miki-fp/Budget_Joycons/3D Models/b3f-1020.stp

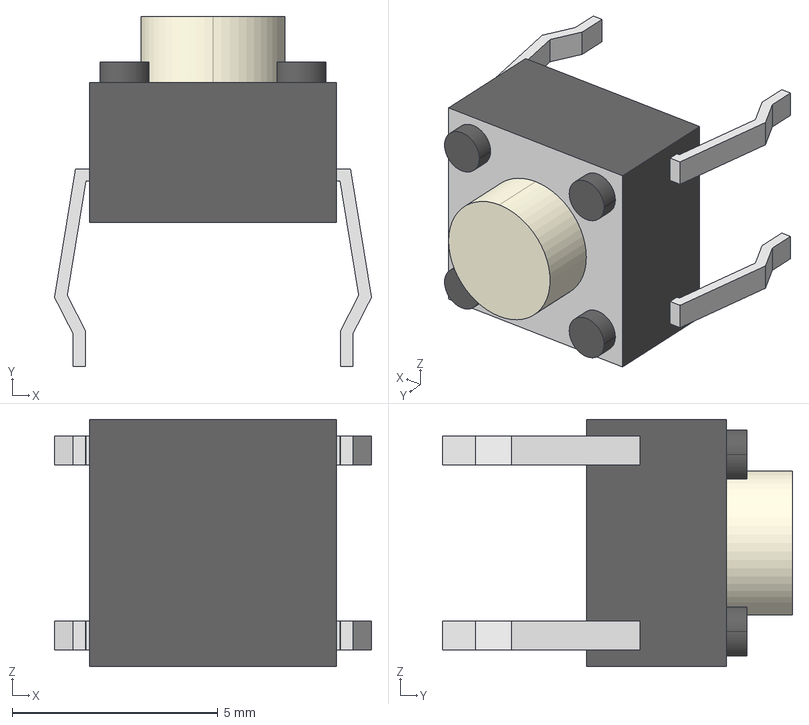
[picture p1: CAD file, 2026-07-12]
3D Models/b3f-1020.stp
7.70 x 8.50 x 6.00 mm
