miki-fp/Budget_Joycons/3D Models/S2B-PH-K-S.STEP

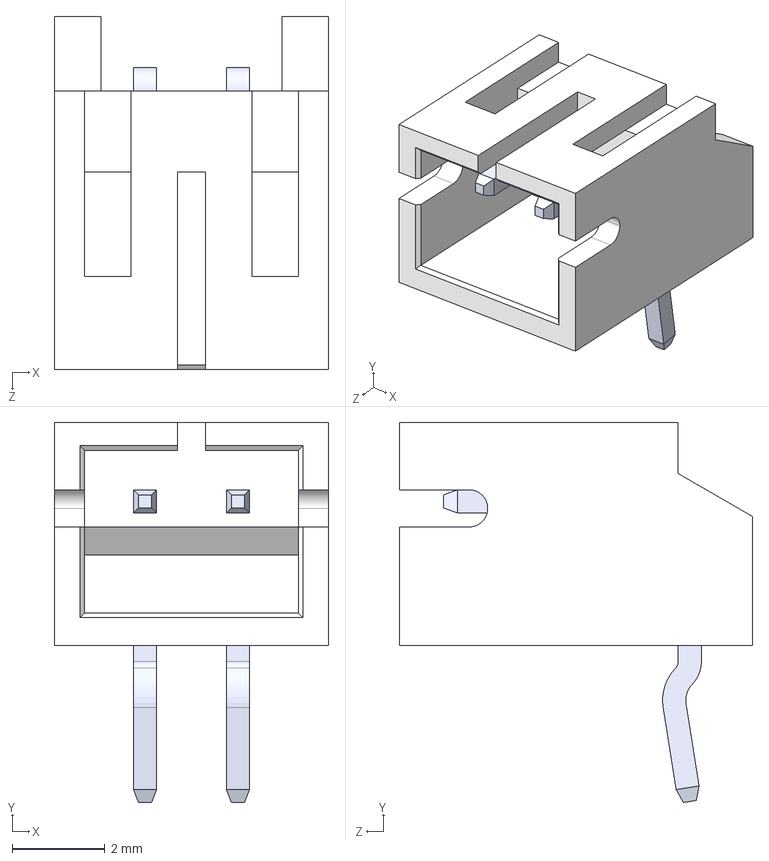
[picture p2: CAD file, 2026-07-12]
3D Models/S2B-PH-K-S.STEP
5.90 x 8.18 x 7.60 mm
