miki-fp/Budget_Joycons/3D Models/UJ20-C-H-G-SMT-2A-P16-TR.step

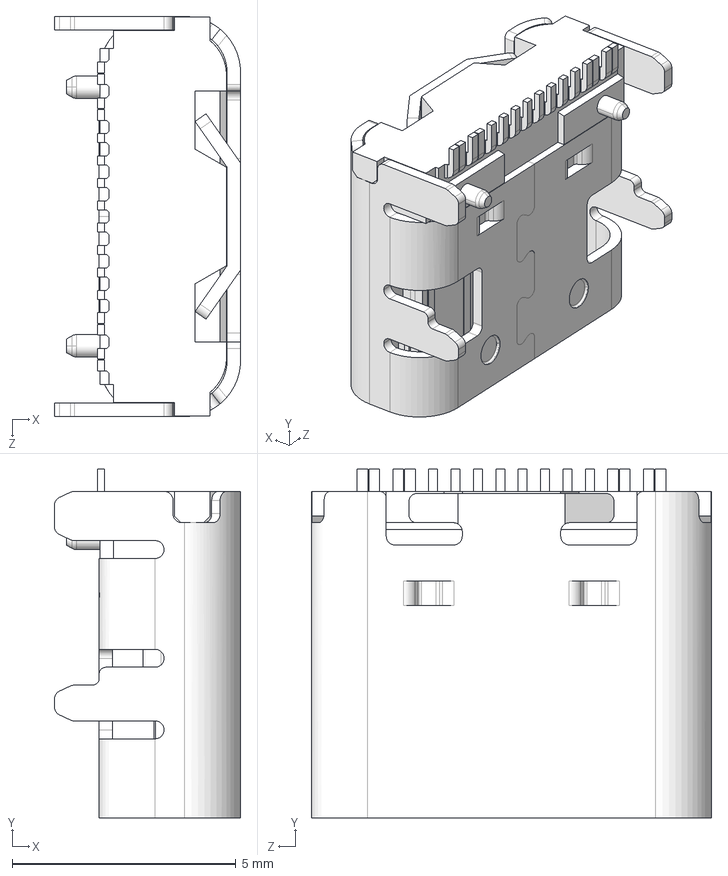
[picture p3: CAD file, 2026-07-12]
3D Models/UJ20-C-H-G-SMT-2A-P16-TR.step
4.16 x 7.80 x 8.94 mm
