miki-fp/Budget_Joycons/3D Models/SKSCLB.STEP

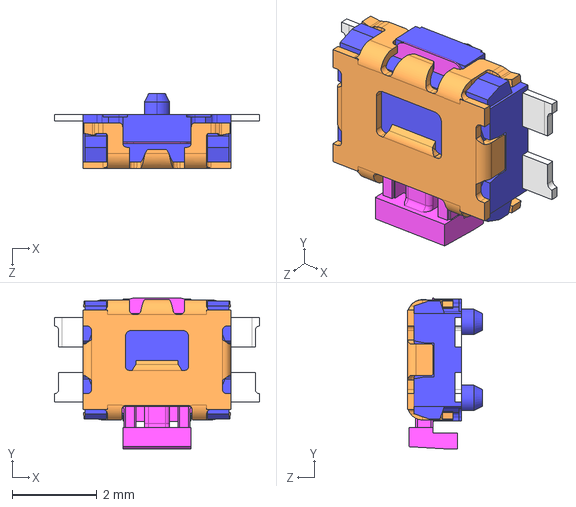
[picture p4: CAD file, 2026-07-12]
3D Models/SKSCLB.STEP
4.85 x 3.57 x 1.77 mm
