miki-fp/Budget_Joycons/3D Models/LQFP48_1_STM.step

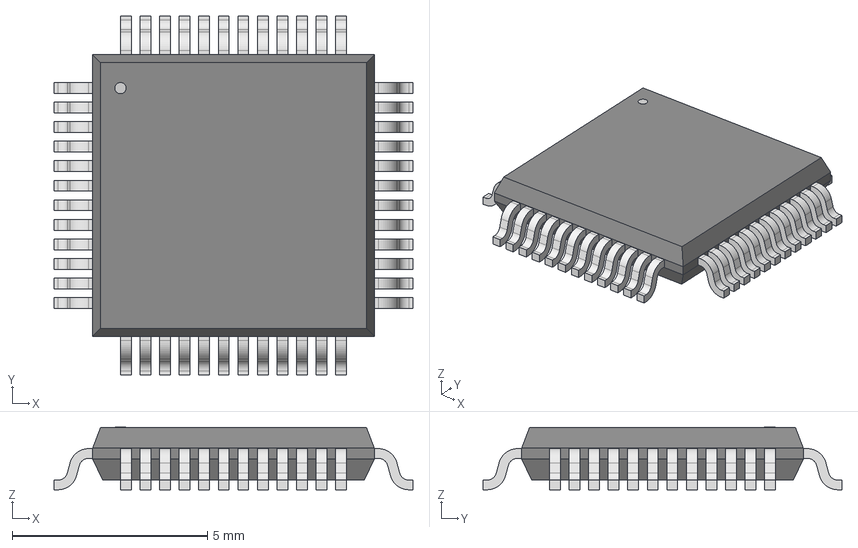
[picture p5: CAD file, 2026-07-12]
3D Models/LQFP48_1_STM.step
9.19 x 9.19 x 1.60 mm
