miki-fp/Budget_Joycons/3D Models/TL3315NF100Q.step

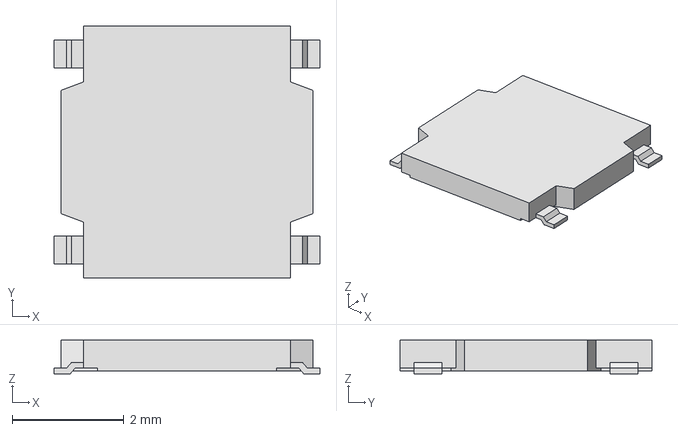
[picture p6: CAD file, 2026-07-12]
3D Models/TL3315NF100Q.step
4.75 x 4.50 x 0.6 mm
