miki-fp/Budget_Joycons/3D Models/SM02B-SRSS-TB_LF__SN_.stp

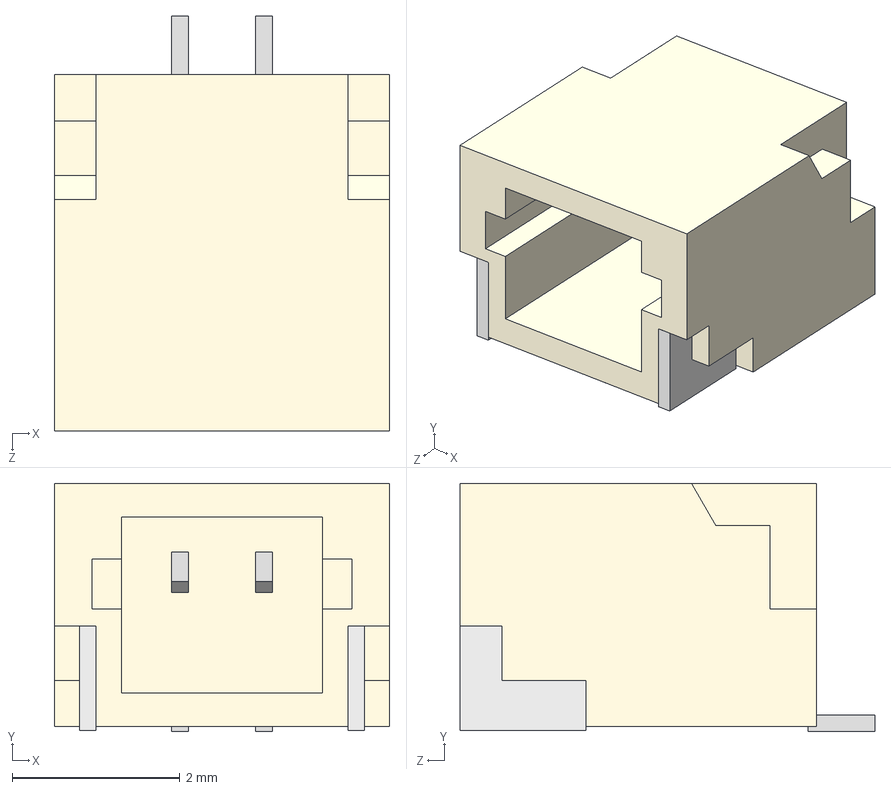
[picture p7: CAD file, 2026-07-12]
3D Models/SM02B-SRSS-TB_LF__SN_.stp
4.00 x 2.96 x 4.95 mm
