miki-fp/Budget_Joycons/3D Models/530480210.stp

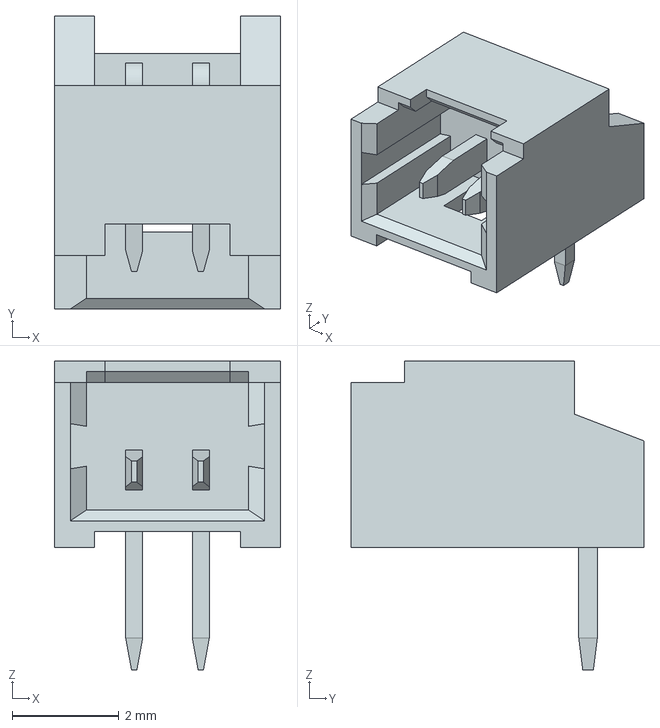
[picture p8: CAD file, 2026-07-12]
3D Models/530480210.stp
4.25 x 5.50 x 5.80 mm
