miki-fp/Budget_Joycons/Right Controller/Budget Joycons (Right).kicad_pcb

## KiCad design Right Controller/Budget Joycons (Right).kicad_pcb (2026-07-15)

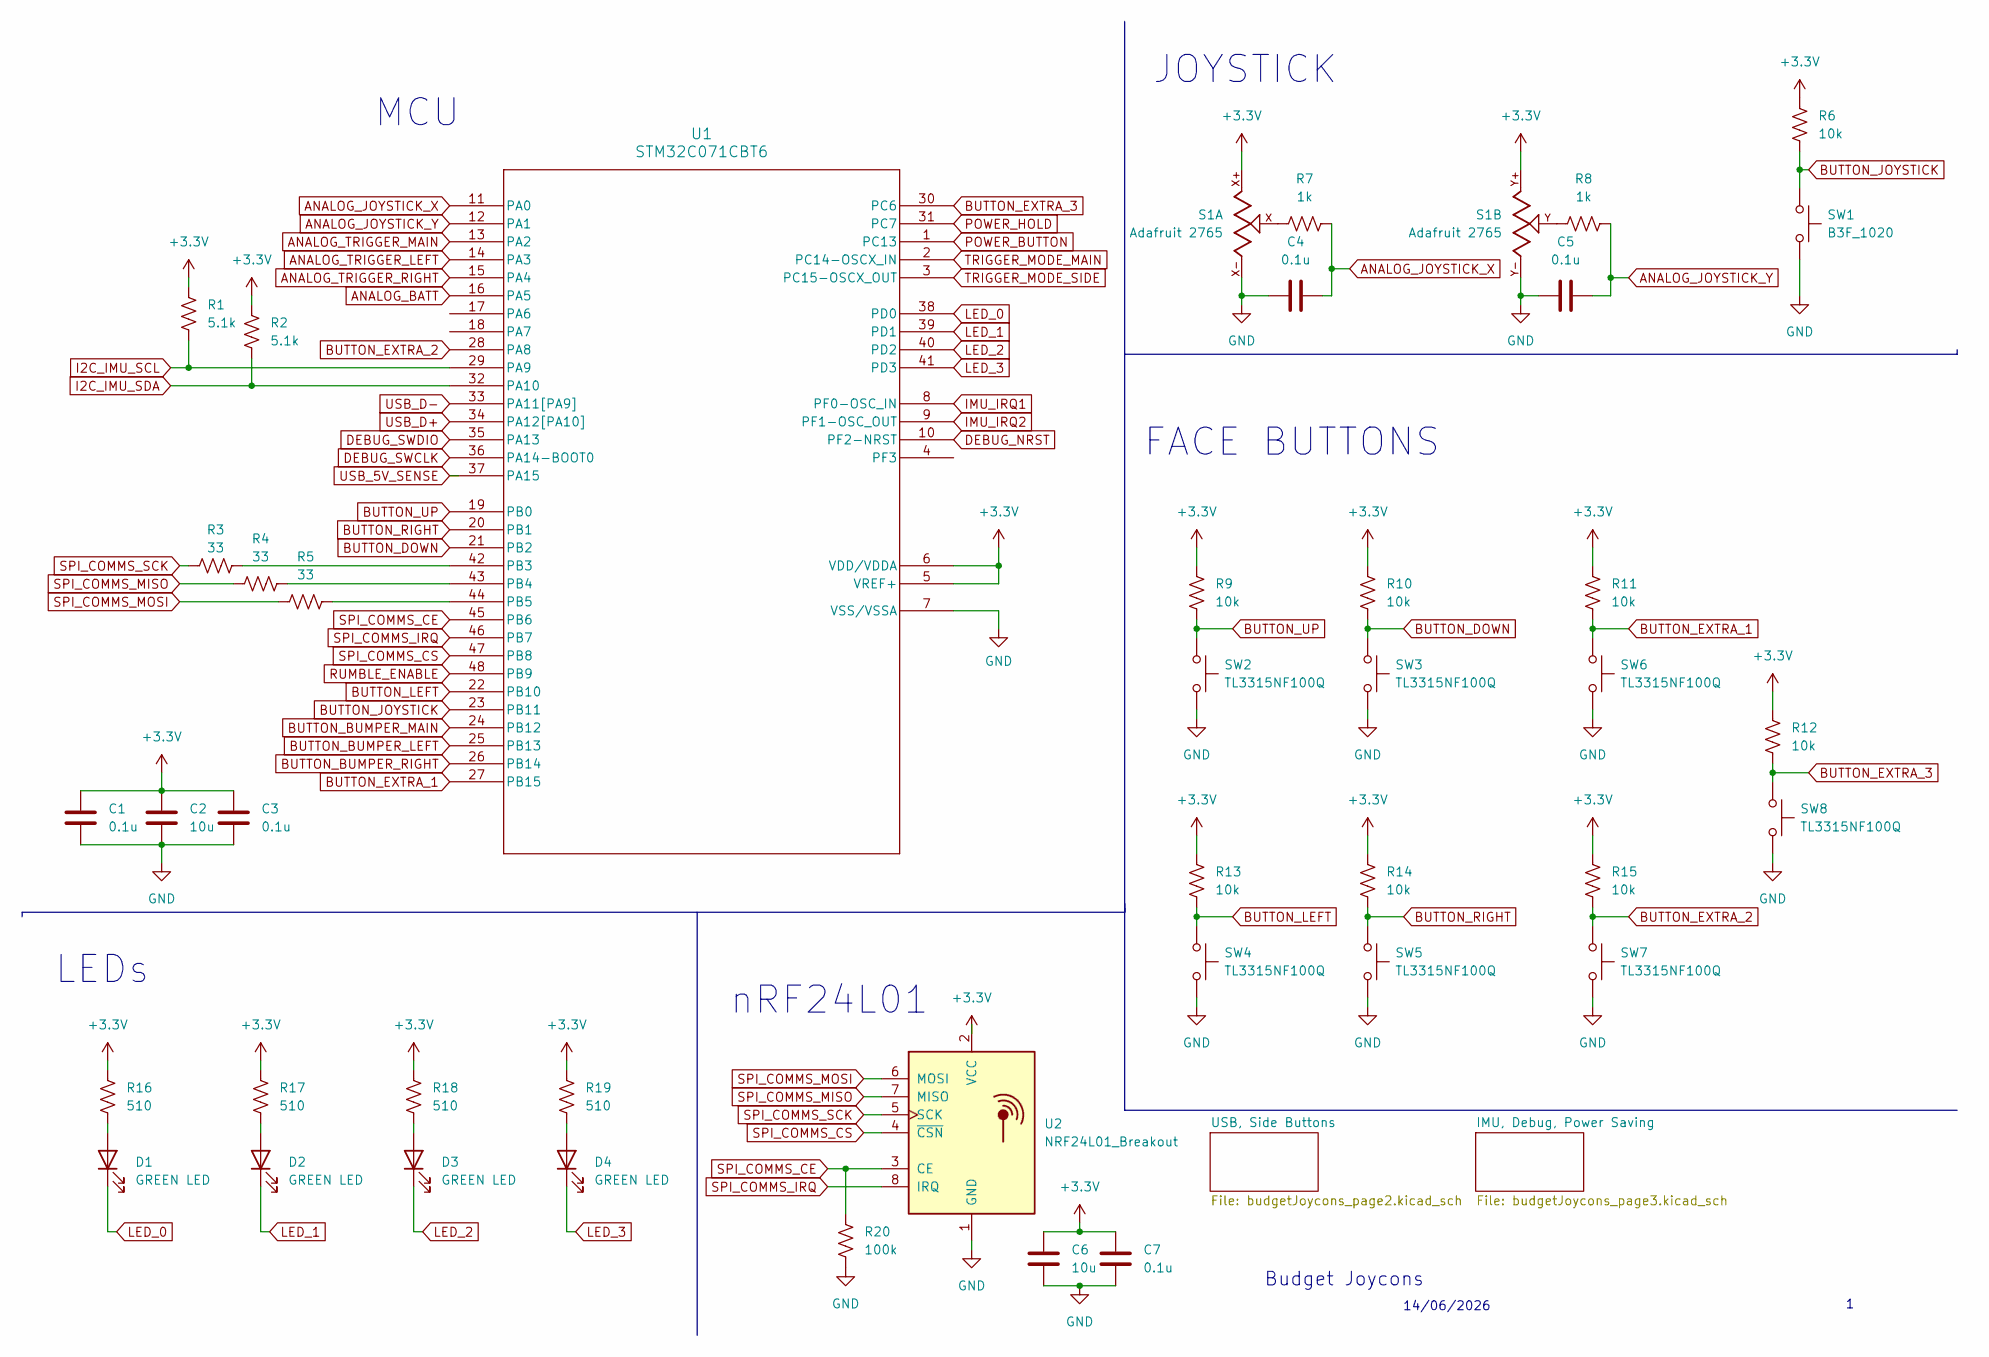
[picture p9: schematic BudgetJoycons_pcb.kicad_sch]

Parts:
C1, C3, C4, C5, C7: 0.1u; C_0603_1608Metric_Pad1.08x0.95mm_HandSolder
C2, C6: 10u; C_0805_2012Metric_Pad1.18x1.45mm_HandSolder
D1, D2, D3, D4: GREEN LED; LED_0805_2012Metric_Pad1.15x1.40mm_HandSolder
R1, R2: 5.1k; R_0603_1608Metric_Pad0.98x0.95mm_HandSolder
R3, R4, R5: 33; R_0603_1608Metric_Pad0.98x0.95mm_HandSolder
R6, R9, R10, R11, R12, R13, R14, R15: 10k; R_0603_1608Metric_Pad0.98x0.95mm_HandSolder
R7, R8: 1k; R_0603_1608Metric_Pad0.98x0.95mm_HandSolder
R16, R17, R18, R19: 510; R_0805_2012Metric_Pad1.20x1.40mm_HandSolder
R20: 100k; R_0603_1608Metric_Pad0.98x0.95mm_HandSolder
S1: Adafruit 2765; Adafruit_Joystick_2765
SW1: B3F_1020; B3F-1020
SW2, SW3, SW4, SW5, SW6, SW7, SW8: TL3315NF100Q; SW_TL3315NF100Q
U1: STM32C071CBT6; LQFP48_1_STM-M
U2: NRF24L01_Breakout; nRF24L01_Breakout

Connections:
+3.3V: C1.1, C2.1, C3.1, C6.1, C7.1, R1.1, R2.1, R6.1, R9.1, R10.1, R11.1, R12.1, R13.1, R14.1, R15.1, R16.1, R17.1, R18.1, R19.1, S1.X+, S1.Y+, U1.5 (VREF+), U1.6 (VDD/VDDA), U2.2 (VCC); also elsewhere on the board
ANALOG_BATT: U1.16 (PA5); also elsewhere on the board
ANALOG_JOYSTICK_X: C4.2, R7.2, U1.11 (PA0)
ANALOG_JOYSTICK_Y: C5.2, R8.2, U1.12 (PA1)
ANALOG_TRIGGER_LEFT: U1.14 (PA3); also elsewhere on the board
ANALOG_TRIGGER_MAIN: U1.13 (PA2); also elsewhere on the board
ANALOG_TRIGGER_RIGHT: U1.15 (PA4); also elsewhere on the board
BUTTON_BUMPER_LEFT: U1.25 (PB13); also elsewhere on the board
BUTTON_BUMPER_MAIN: U1.24 (PB12); also elsewhere on the board
BUTTON_BUMPER_RIGHT: U1.26 (PB14); also elsewhere on the board
BUTTON_DOWN: R10.2, SW3.1, U1.21 (PB2)
BUTTON_EXTRA_1: R11.2, SW6.1, U1.27 (PB15)
BUTTON_EXTRA_2: R15.2, SW7.1, U1.28 (PA8)
BUTTON_EXTRA_3: R12.2, SW8.1, U1.30 (PC6)
BUTTON_JOYSTICK: R6.2, SW1.1, U1.23 (PB11)
BUTTON_LEFT: R13.2, SW4.1, U1.22 (PB10)
BUTTON_RIGHT: R14.2, SW5.1, U1.20 (PB1)
BUTTON_UP: R9.2, SW2.1, U1.19 (PB0)
DEBUG_NRST: U1.10 (PF2-NRST); also elsewhere on the board
DEBUG_SWCLK: U1.36 (PA14-BOOT0); also elsewhere on the board
DEBUG_SWDIO: U1.35 (PA13); also elsewhere on the board
GND: C1.2, C2.2, C3.2, C4.1, C5.1, C6.2, C7.2, R20.2, S1.X-, S1.Y-, SW1.2, SW2.2, SW3.2, SW4.2, SW5.2, SW6.2, SW7.2, SW8.2, U1.7 (VSS/VSSA), U2.1 (GND); also elsewhere on the board
I2C_IMU_SCL: R1.2, U1.29 (PA9); also elsewhere on the board
I2C_IMU_SDA: R2.2, U1.32 (PA10); also elsewhere on the board
IMU_IRQ1: U1.8 (PF0-OSC_IN); also elsewhere on the board
IMU_IRQ2: U1.9 (PF1-OSC_OUT); also elsewhere on the board
LED_0: D1.1 (K), U1.38 (PD0)
LED_1: D2.1 (K), U1.39 (PD1)
LED_2: D3.1 (K), U1.40 (PD2)
LED_3: D4.1 (K), U1.41 (PD3)
unnamed: D1.2 (A), R16.2
unnamed: D2.2 (A), R17.2
unnamed: D3.2 (A), R18.2
unnamed: D4.2 (A), R19.2
unnamed: R7.1, S1.X
unnamed: R8.1, S1.Y
unnamed: R3.1, U1.42 (PB3)
unnamed: R4.1, U1.43 (PB4)
unnamed: R5.1, U1.44 (PB5)
POWER_BUTTON: U1.1 (PC13); also elsewhere on the board
POWER_HOLD: U1.31 (PC7); also elsewhere on the board
RUMBLE_ENABLE: U1.48 (PB9); also elsewhere on the board
SPI_COMMS_CE: R20.1, U1.45 (PB6), U2.3 (CE)
SPI_COMMS_CS: U1.47 (PB8), U2.4 (~CSN)
SPI_COMMS_IRQ: U1.46 (PB7), U2.8 (IRQ)
SPI_COMMS_MISO: R4.2, U2.7 (MISO)
SPI_COMMS_MOSI: R5.2, U2.6 (MOSI)
SPI_COMMS_SCK: R3.2, U2.5 (SCK)
TRIGGER_MODE_MAIN: U1.2 (PC14-OSCX_IN); also elsewhere on the board
TRIGGER_MODE_SIDE: U1.3 (PC15-OSCX_OUT); also elsewhere on the board
USB_5V_SENSE: U1.37 (PA15); also elsewhere on the board
USB_D+: U1.34 (PA12[PA10]); also elsewhere on the board
USB_D-: U1.33 (PA11[PA9]); also elsewhere on the board

Notes on the sheet:
14/06/2026
FACE BUTTONS
MCU
JOYSTICK
Budget Joycons
LEDs
nRF24L01

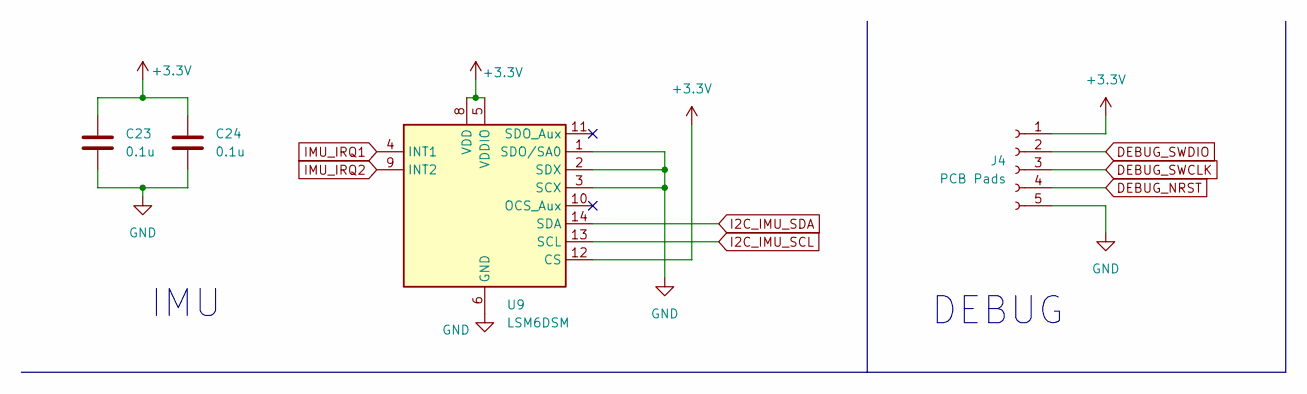
[picture p10: schematic budgetJoycons_page3.kicad_sch]

Parts:
C23, C24: 0.1u; C_0603_1608Metric_Pad1.08x0.95mm_HandSolder
J4: PCB Pads; Edge_2.54mm_Pads
U9: LSM6DSM; LGA-14_3x2.5mm_P0.5mm_LayoutBorder3x4y

Connections:
+3.3V: C23.2, C24.2, J4.1, U9.5 (VDDIO), U9.8 (VDD), U9.12 (CS); also elsewhere on the board
DEBUG_NRST: J4.4; also elsewhere on the board
DEBUG_SWCLK: J4.3; also elsewhere on the board
DEBUG_SWDIO: J4.2; also elsewhere on the board
GND: C23.1, C24.1, J4.5, U9.1 (SDO/SA0), U9.2 (SDX), U9.3 (SCX), U9.6 (GND), U9.7 (GND); also elsewhere on the board
I2C_IMU_SCL: U9.13 (SCL); also elsewhere on the board
I2C_IMU_SDA: U9.14 (SDA); also elsewhere on the board
IMU_IRQ1: U9.4 (INT1); also elsewhere on the board
IMU_IRQ2: U9.9 (INT2); also elsewhere on the board

Notes on the sheet:
DEBUG
IMU

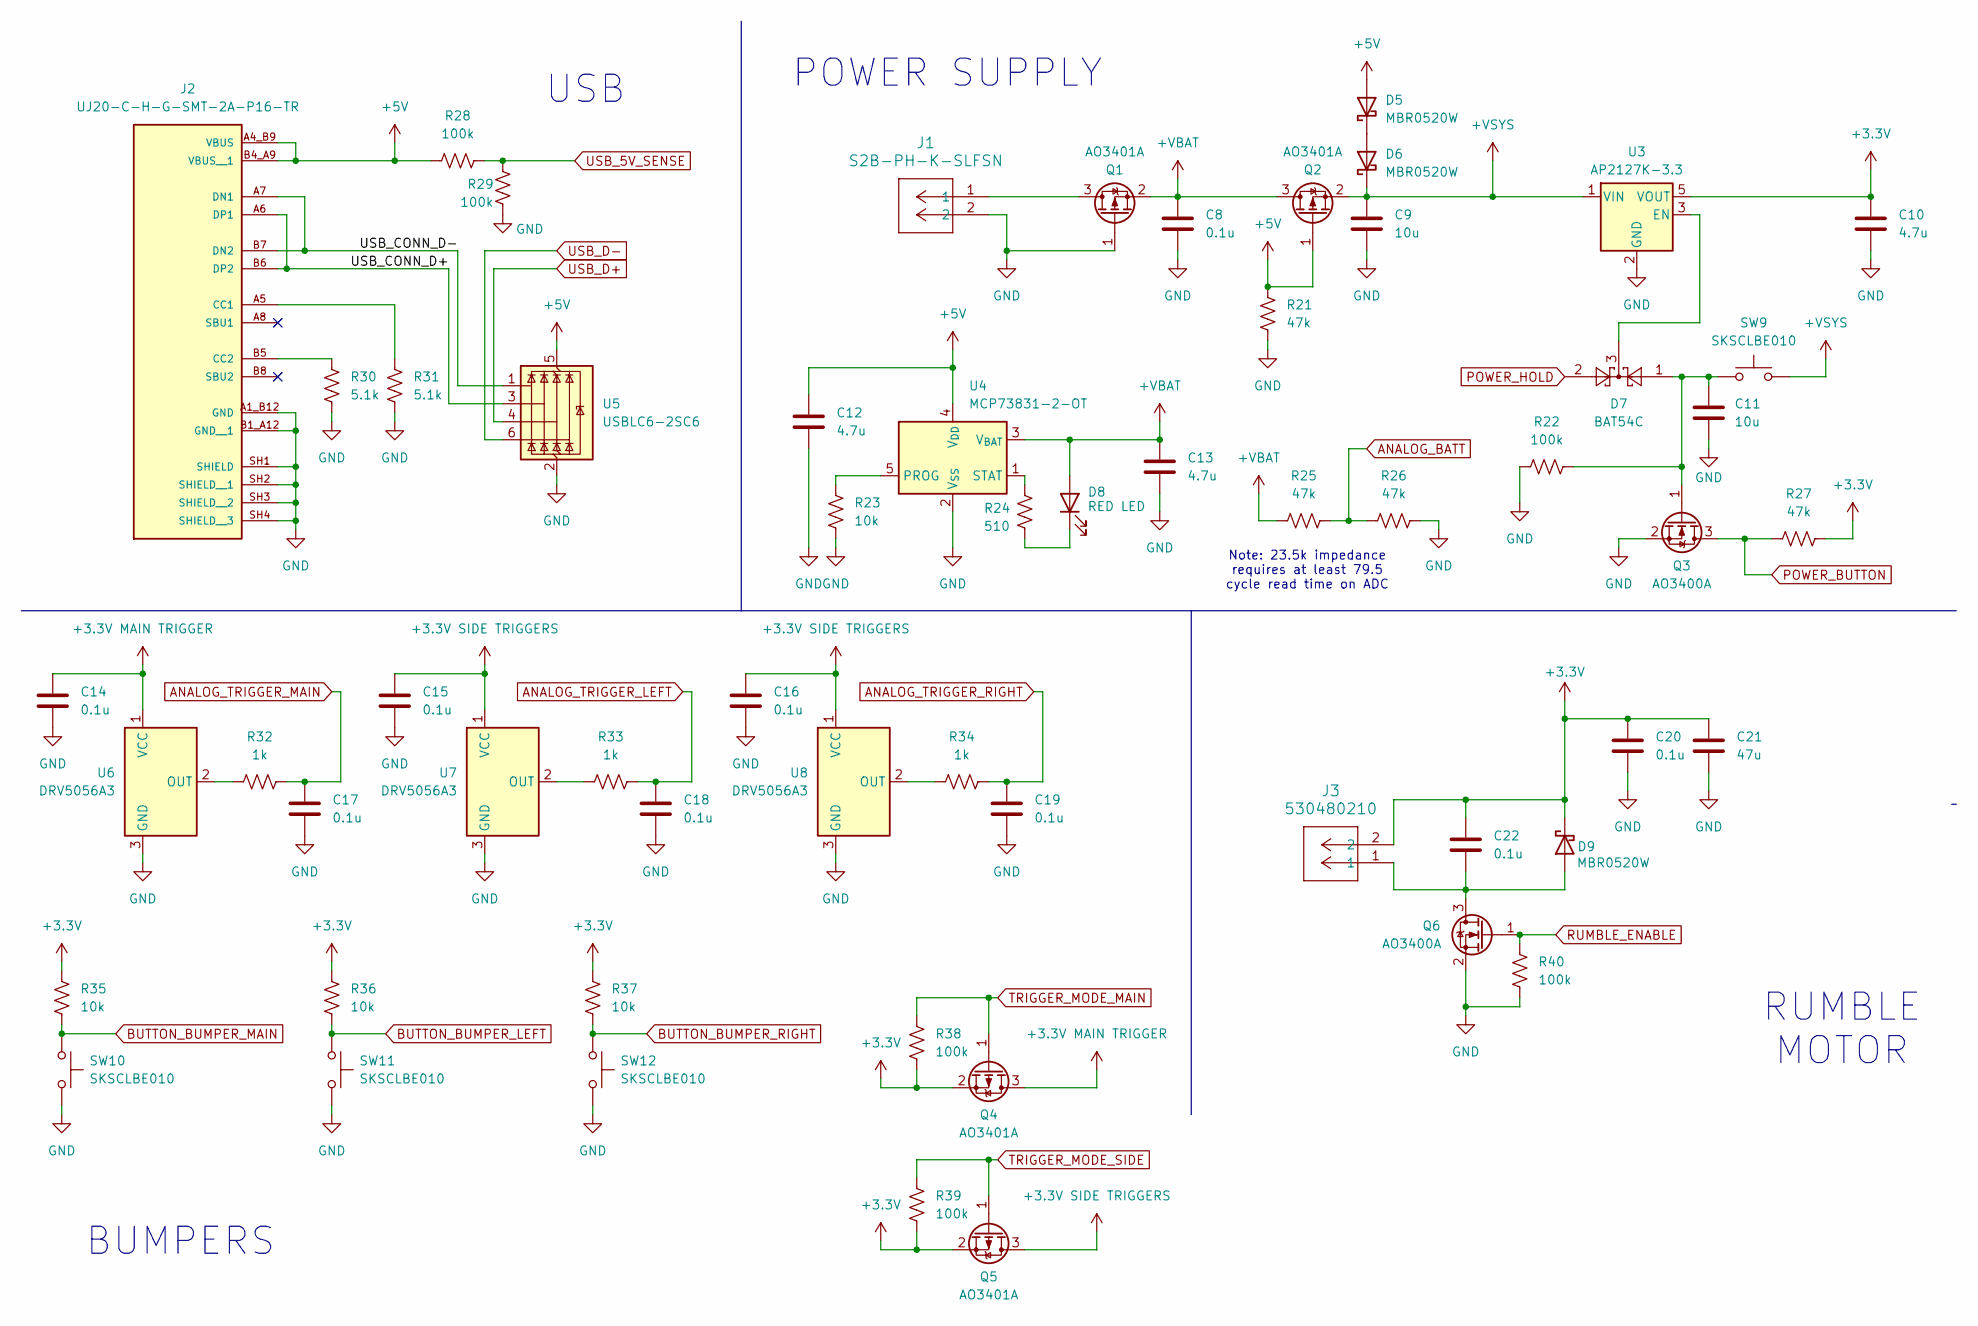
[picture p11: schematic budgetJoycons_page2.kicad_sch]

Parts:
C8, C14, C15, C16, C17, C18, C19, C20, C22: 0.1u; C_0603_1608Metric_Pad1.08x0.95mm_HandSolder
C9, C11: 10u; C_0805_2012Metric_Pad1.18x1.45mm_HandSolder
C10, C12, C13: 4.7u; C_0603_1608Metric_Pad1.08x0.95mm_HandSolder
C21: 47u; C_1206_3216Metric_Pad1.33x1.80mm_HandSolder
D5, D6, D9: MBR0520W; D_SOD-123
D7: BAT54C; SOT-23
D8: RED LED; LED_0805_2012Metric_Pad1.15x1.40mm_HandSolder
J1: S2B-PH-K-SLFSN; CONN_S2B-PH-K-S_JST
J2: UJ20-C-H-G-SMT-2A-P16-TR; SAMESKY_UJ20-C-H-G-SMT-2A-P16-TR; PARTREV 1.0
J3: 530480210; CONN02_530480210_MOL
Q1, Q2, Q4, Q5: AO3401A; SOT-23
Q3, Q6: AO3400A; SOT-23
R21, R25, R26, R27: 47k; R_0603_1608Metric_Pad0.98x0.95mm_HandSolder
R22, R28, R29, R38, R39, R40: 100k; R_0603_1608Metric_Pad0.98x0.95mm_HandSolder
R23, R35, R36, R37: 10k; R_0603_1608Metric_Pad0.98x0.95mm_HandSolder
R24: 510; R_0805_2012Metric_Pad1.20x1.40mm_HandSolder
R30, R31: 5.1k; R_0603_1608Metric_Pad0.98x0.95mm_HandSolder
R32, R33, R34: 1k; R_0603_1608Metric_Pad0.98x0.95mm_HandSolder
SW9, SW10, SW11, SW12: SKSCLBE010; SKSCLDE010
U3: AP2127K-3.3; SOT-23-5
U4: MCP73831-2-OT; SOT-23-5
U5: USBLC6-2SC6; SOT-23-6
U6, U7, U8: DRV5056A3; SOT-23-3

Connections:
+3.3V: C10.1, C20.1, C21.1, C22.1, D9.1 (K), J3.2, Q4.2 (S), Q5.2 (S), R27.2, R35.1, R36.1, R37.1, R38.2, R39.2, U3.5 (VOUT); also elsewhere on the board
+3.3V MAIN TRIGGER: C14.1, Q4.3 (D), U6.1 (VCC)
+3.3V SIDE TRIGGERS: C15.1, C16.1, Q5.3 (D), U7.1 (VCC), U8.1 (VCC)
+5V: C12.1, D5.2 (A), J2.A4_B9 (VBUS), J2.B4_A9 (VBUS__1), Q2.1 (G), R21.1, R28.2, U4.4 (V_{DD}), U5.5 (VBUS)
+VBAT: C8.1, C13.1, D8.2 (A), Q1.2 (S), Q2.3 (D), R25.1, U4.3 (V_{BAT})
+VSYS: C9.1, D6.1 (K), Q2.2 (S), SW9.2, U3.1 (VIN)
/Link/USB, Side Buttons/USB_CONN_D+: J2.A6 (DP1), J2.B6 (DP2), U5.3 (I/O2)
/Link/USB, Side Buttons/USB_CONN_D-: J2.A7 (DN1), J2.B7 (DN2), U5.1 (I/O1)
ANALOG_BATT: R25.2, R26.2; also elsewhere on the board
ANALOG_TRIGGER_LEFT: C18.1, R33.2; also elsewhere on the board
ANALOG_TRIGGER_MAIN: C17.1, R32.2; also elsewhere on the board
ANALOG_TRIGGER_RIGHT: C19.1, R34.2; also elsewhere on the board
BUTTON_BUMPER_LEFT: R36.2, SW11.1; also elsewhere on the board
BUTTON_BUMPER_MAIN: R35.2, SW10.1; also elsewhere on the board
BUTTON_BUMPER_RIGHT: R37.2, SW12.1; also elsewhere on the board
GND: C8.2, C9.2, C10.2, C11.2, C12.2, C13.2, C14.2, C15.2, C16.2, C17.2, C18.2, C19.2, C20.2, C21.2, J1.2, J2.A1_B12 (GND), J2.B1_A12 (GND__1), J2.SH1 (SHIELD), J2.SH2 (SHIELD__1), J2.SH3 (SHIELD__2), J2.SH4 (SHIELD__3), Q1.1 (G), Q3.2 (S), Q6.2 (S), R21.2, R22.1, R23.2, R26.1, R29.2, R30.2, R31.2, R40.2, SW10.2, SW11.2, SW12.2, U3.2 (GND), U4.2 (V_{SS}), U5.2 (GND), U6.3 (GND), U7.3 (GND), U8.3 (GND); also elsewhere on the board
unnamed: D5.1 (K), D6.2 (A)
unnamed: D8.1 (K), R24.2
unnamed: C22.2, D9.2 (A), J3.1, Q6.3 (D)
unnamed: J2.A5 (CC1), R31.1
unnamed: J2.B5 (CC2), R30.1
unnamed: J1.1, Q1.3 (D)
unnamed: C11.1, D7.1, Q3.1 (G), R22.2, SW9.1
unnamed: D7.3, U3.3 (EN)
unnamed: R23.1, U4.5 (PROG)
unnamed: R24.1, U4.1 (STAT)
unnamed: R32.1, U6.2 (OUT)
unnamed: R33.1, U7.2 (OUT)
unnamed: R34.1, U8.2 (OUT)
POWER_BUTTON: Q3.3 (D), R27.1; also elsewhere on the board
POWER_HOLD: D7.2; also elsewhere on the board
RUMBLE_ENABLE: Q6.1 (G), R40.1; also elsewhere on the board
TRIGGER_MODE_MAIN: Q4.1 (G), R38.1; also elsewhere on the board
TRIGGER_MODE_SIDE: Q5.1 (G), R39.1; also elsewhere on the board
USB_5V_SENSE: R28.1, R29.1; also elsewhere on the board
USB_D+: U5.4 (I/O3); also elsewhere on the board
USB_D-: U5.6 (I/O4); also elsewhere on the board

Notes on the sheet:
BUMPERS
USB
POWER SUPPLY
Note: 23.5k impedance requires at least 79.5 cycle read time on ADC
RUMBLE MOTOR

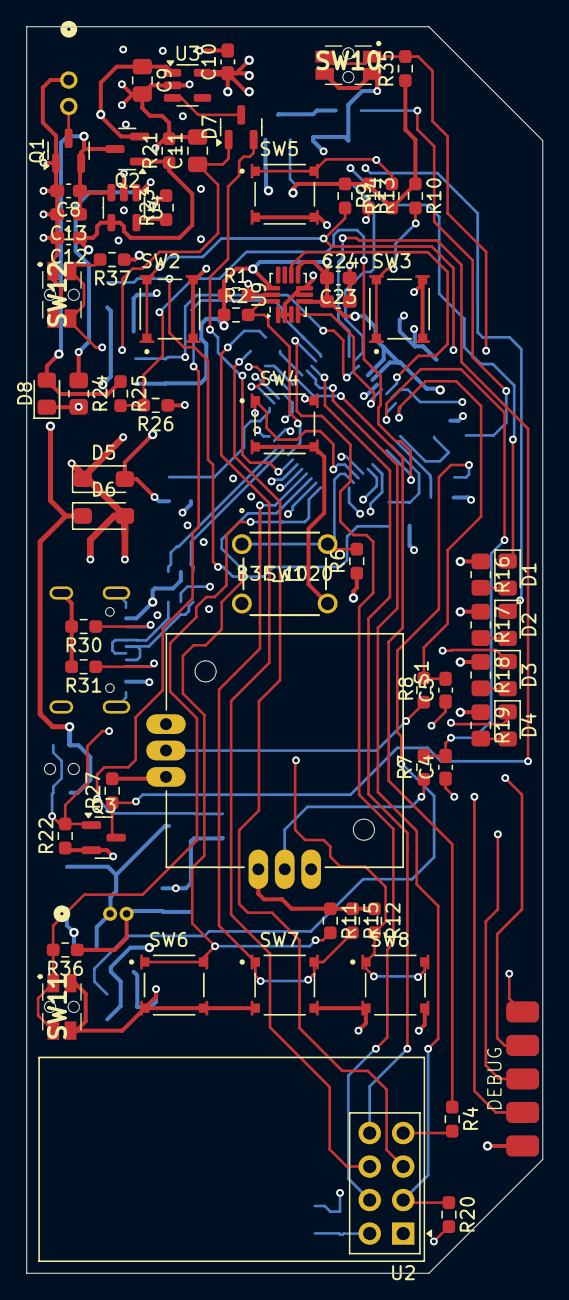
[picture p12: board Budget Joycons (Right).kicad_pcb from above]

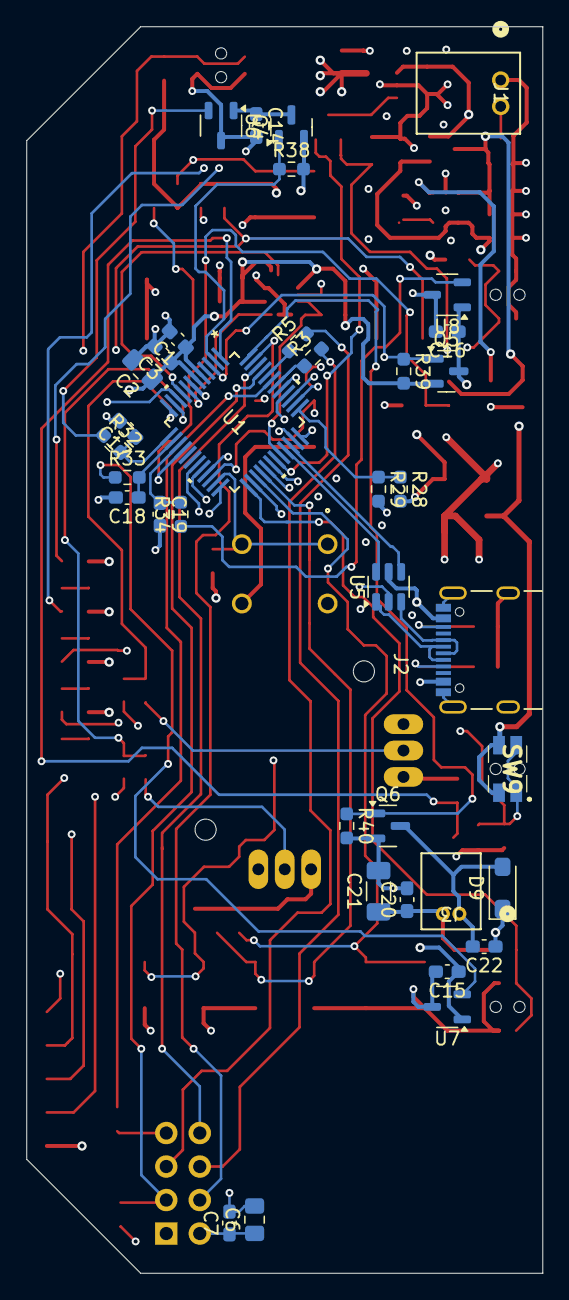
[picture p13: board Budget Joycons (Right).kicad_pcb from below]

Board: 4 copper layers, 39.1 x 94.5 mm, 105 parts (37 on the bottom side), 73 nets.
