miki-fp/Budget_Joycons/(commit log)

2026-07-12 Upload Progress for PC download
    [530480210.stp, Budget Joycons (Left).kicad_pcb, Budget Joycons (Left).kicad_sch, Budget Joycons (Right).kicad_pcb, Budget Joycons (Right).kicad_sch, BudgetJoycons_pcb.kicad_sch, LQFP48_1_STM.step, S2B-PH-K-S.STEP]
2026-07-12 Right Update
    [Budget Joycons (Right).kicad_pcb]
2026-07-15 Further Right Side Updates
    [Budget Joycons (Right).kicad_pcb]
2026-07-15 Pre DRC right upload
    [Budget Joycons (Right).kicad_pcb, Budget Joycons (Right).kicad_sch]
